PR77/A500_ACCEL_RAM_IDE-Rev-1/Hardware/A500_ACCEL_RAM_IDE.kicad_pcb.pdf

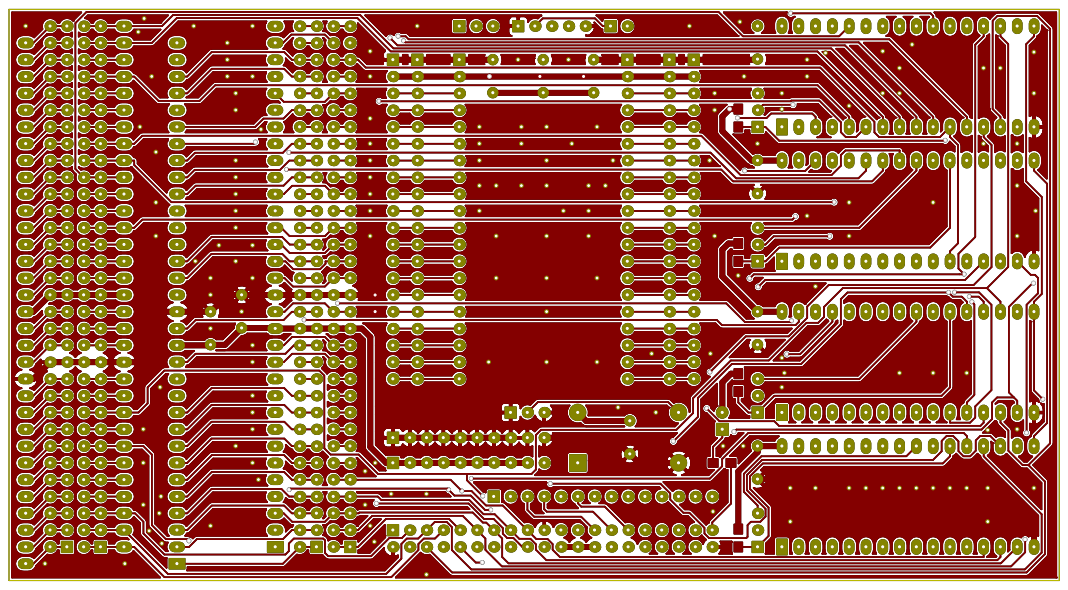
[picture p5: page 1]

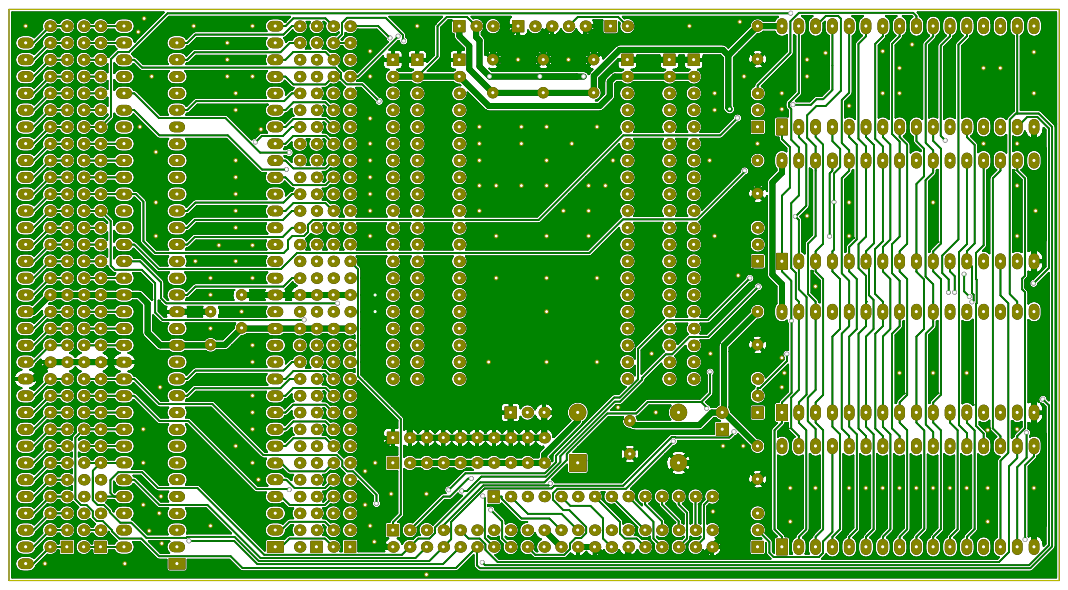
[picture p6: page 2]
