PR77/A500_ACCEL_RAM_IDE-Rev-1/Hardware/A500_ACCEL_RAM_IDE.pdf

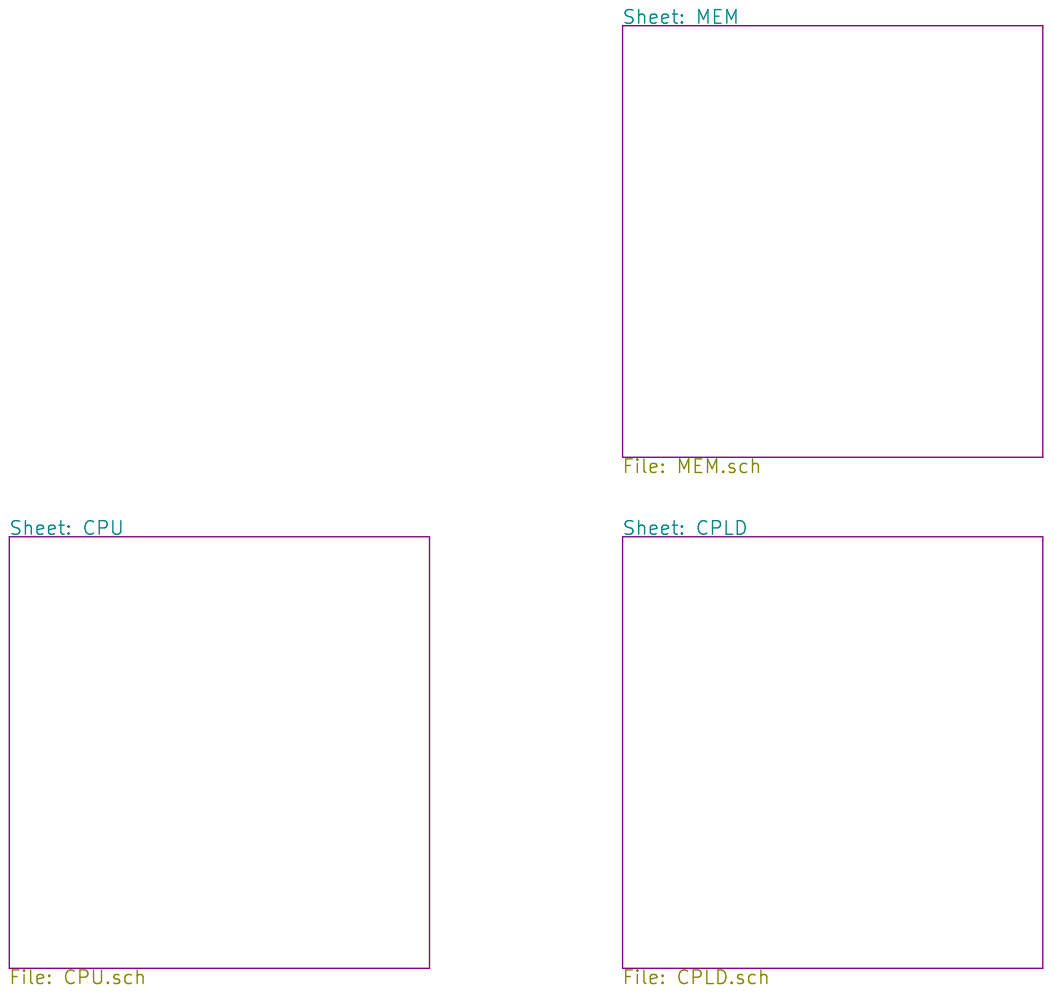
[picture p7: page 1]

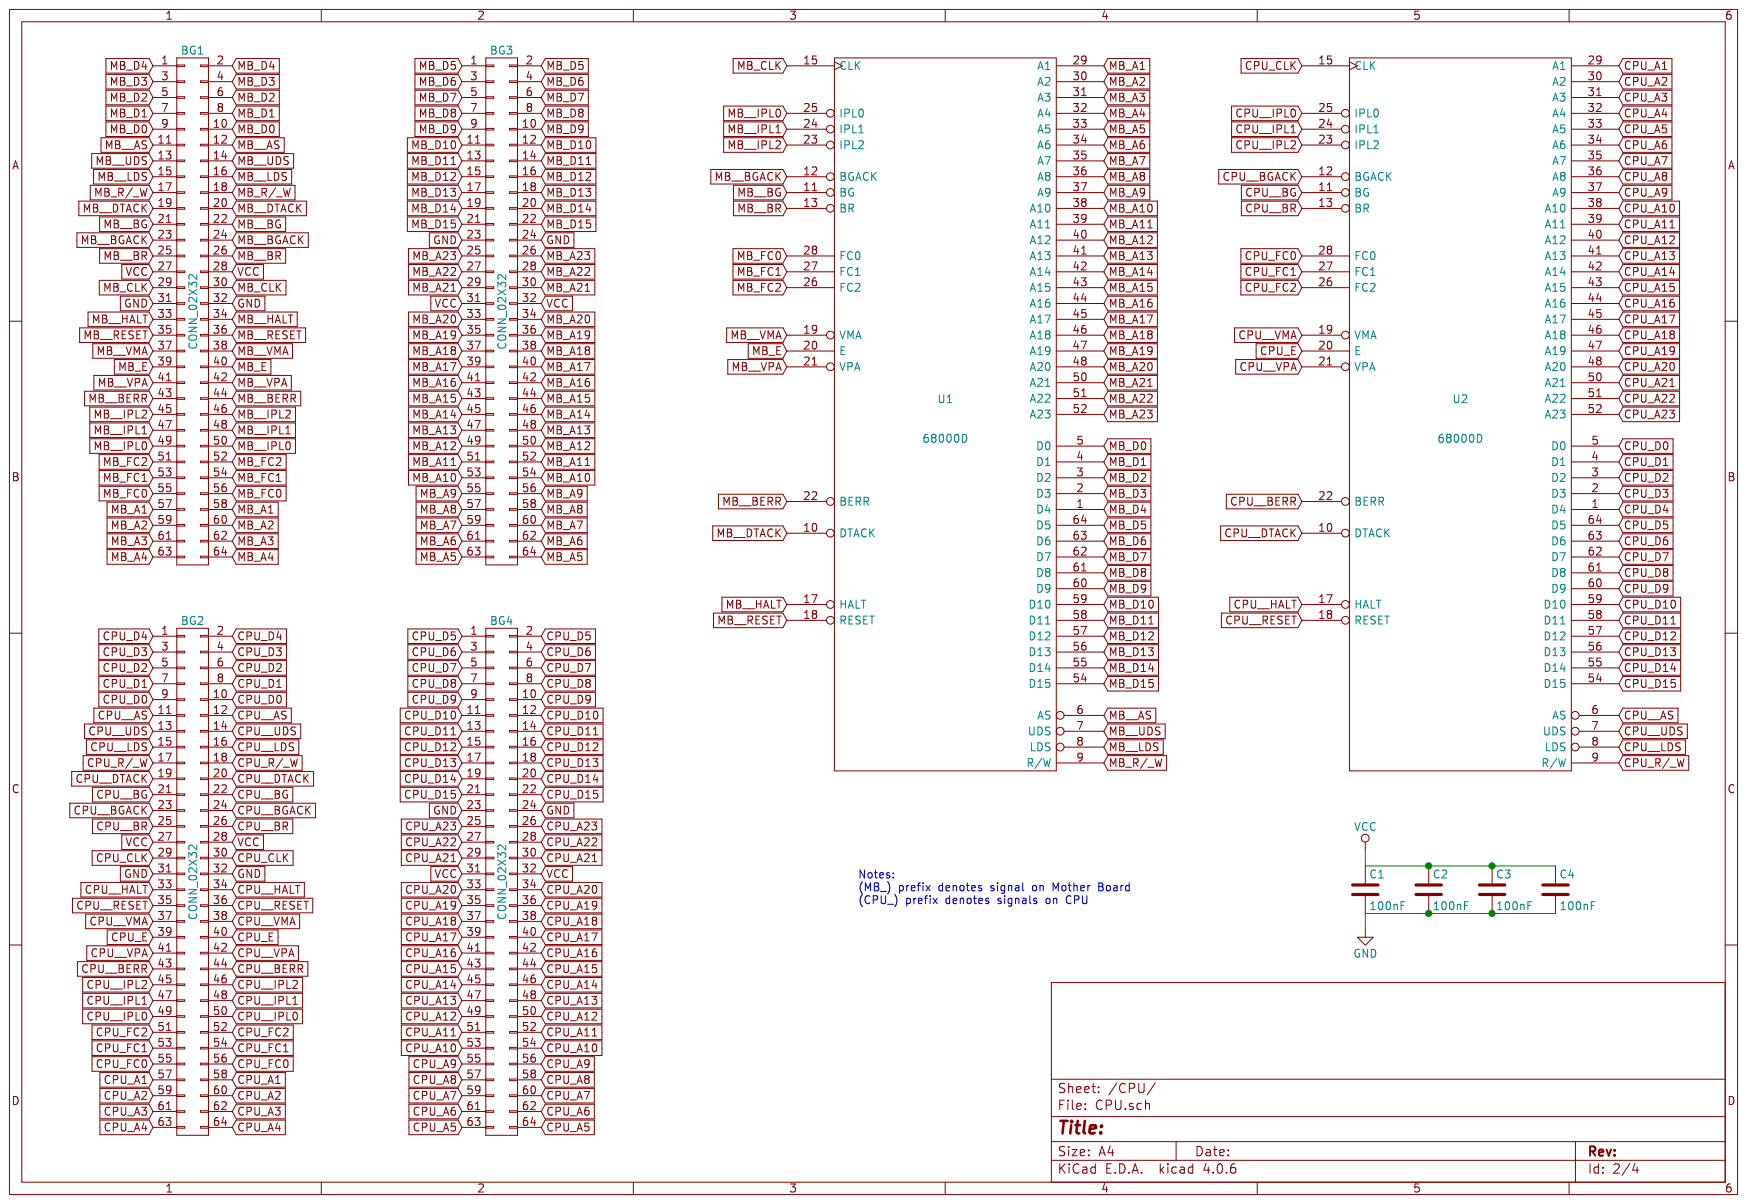
[picture p8: page 2]

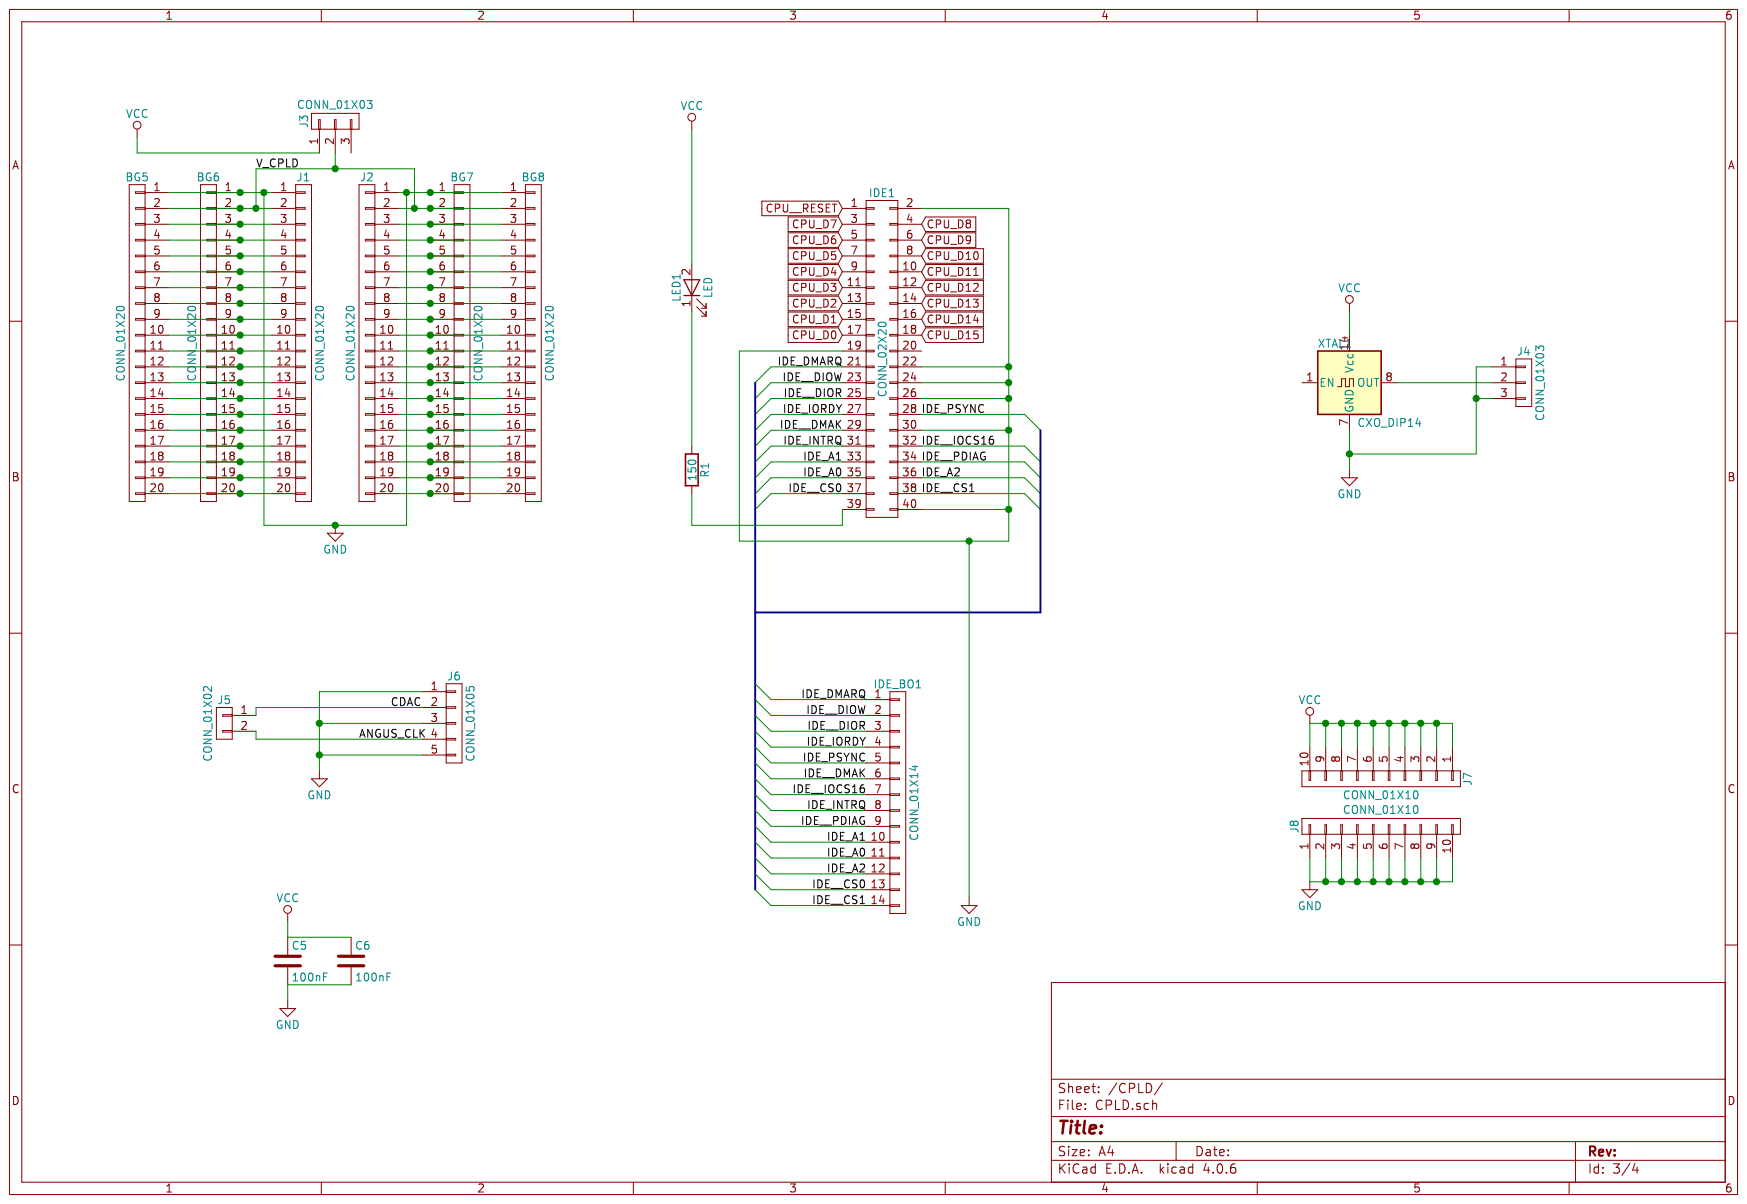
[picture p9: page 3]

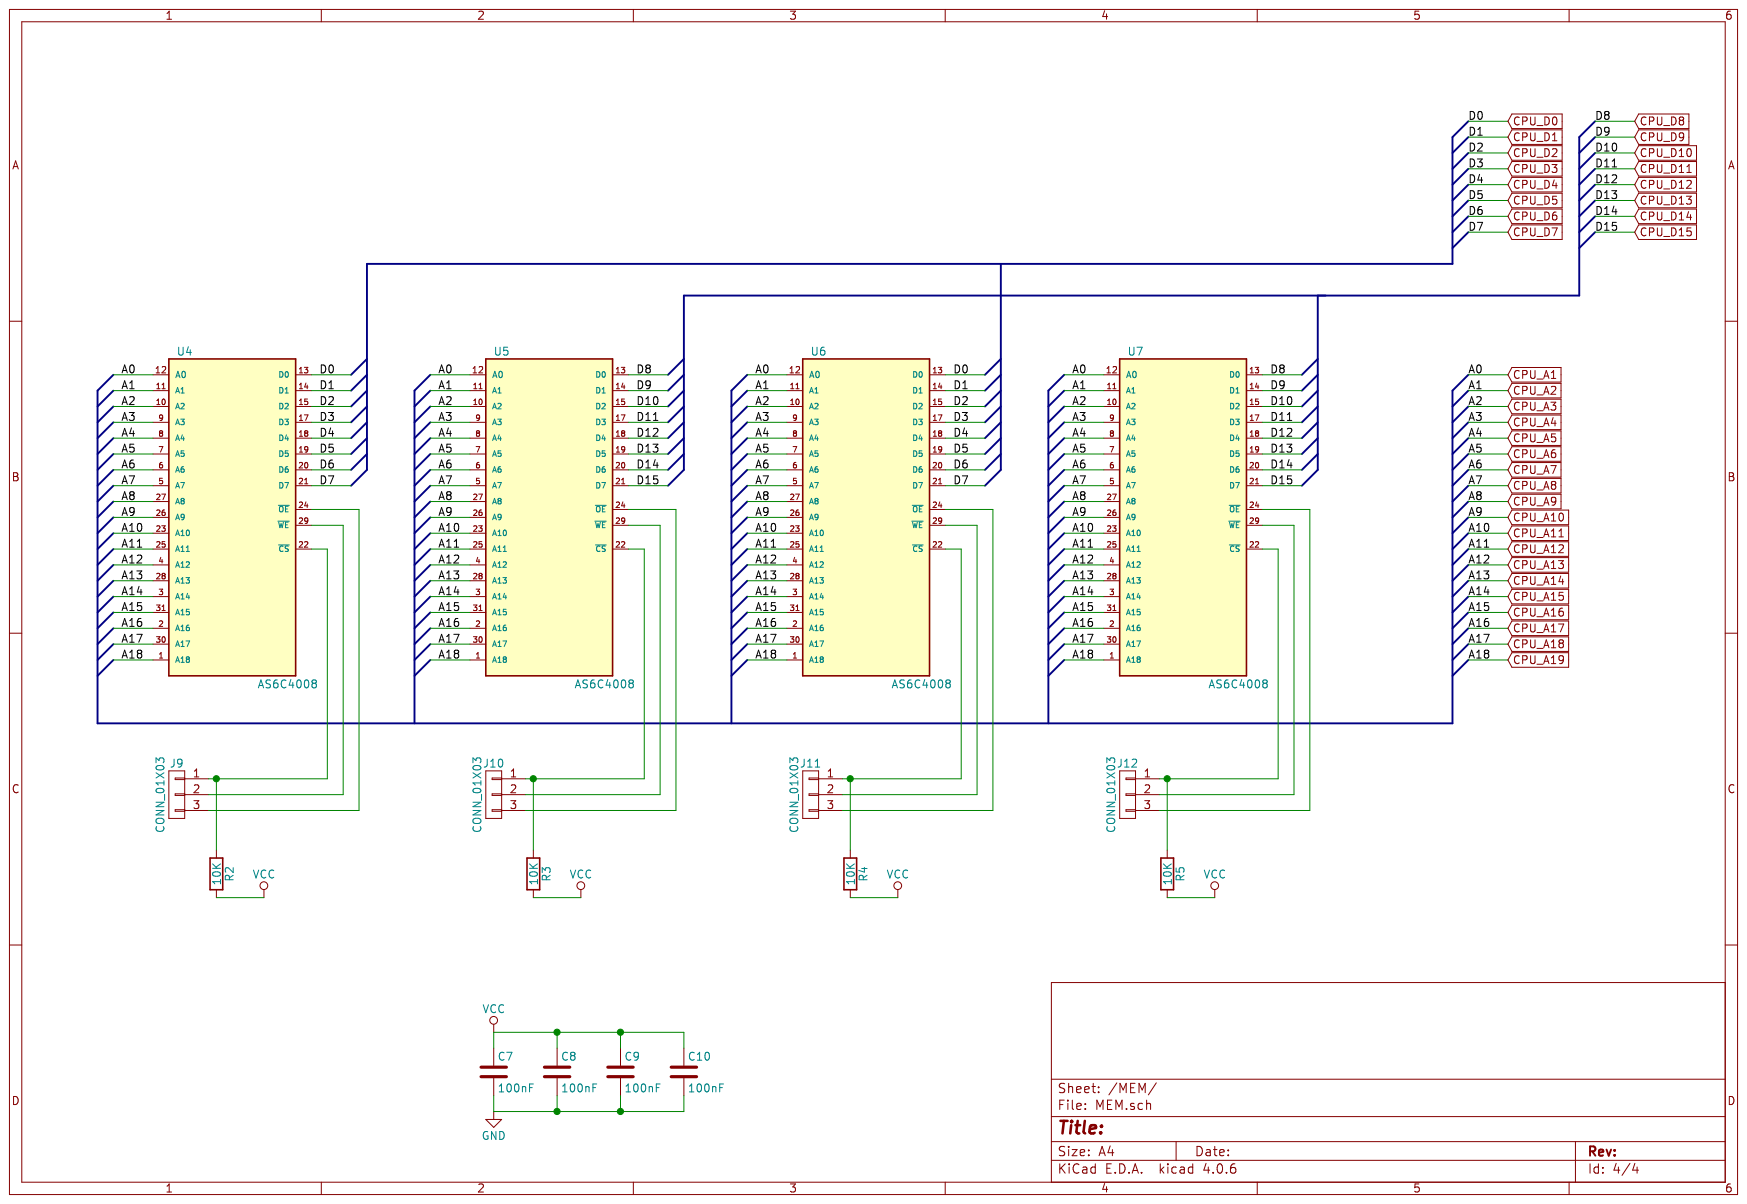
[picture p10: page 4]
