PR77/A500_ACCEL_RAM_IDE-Rev-1/(notices)

Notices in the files:
Logic/ACCEL/A500_ACCEL.v:
modify it under the terms of the GNU General Public License as
published by the Free Software Foundation, either version 3 of the
License, or (at your option) any later version.
